VCHSRobots/RefWBot/sharedlib/README.md

### Shared Lib for both PC and RPi Based Programs

Some custom packages and modules need to be used by both the 
pc and the Raspberry Pi programs. These are stored here.
