VCHSRobots/RefWBot/pc/archive/README.md

### PC Water Bot Discarded Code Folder (Archive)

This folder contains python and related files that are no longer needed, or are somehow obsolete.
  They are kept here in case we need to refer to them to see how something was done.
