VCHSRobots/RefWBot/control_sys_white_board.jpg

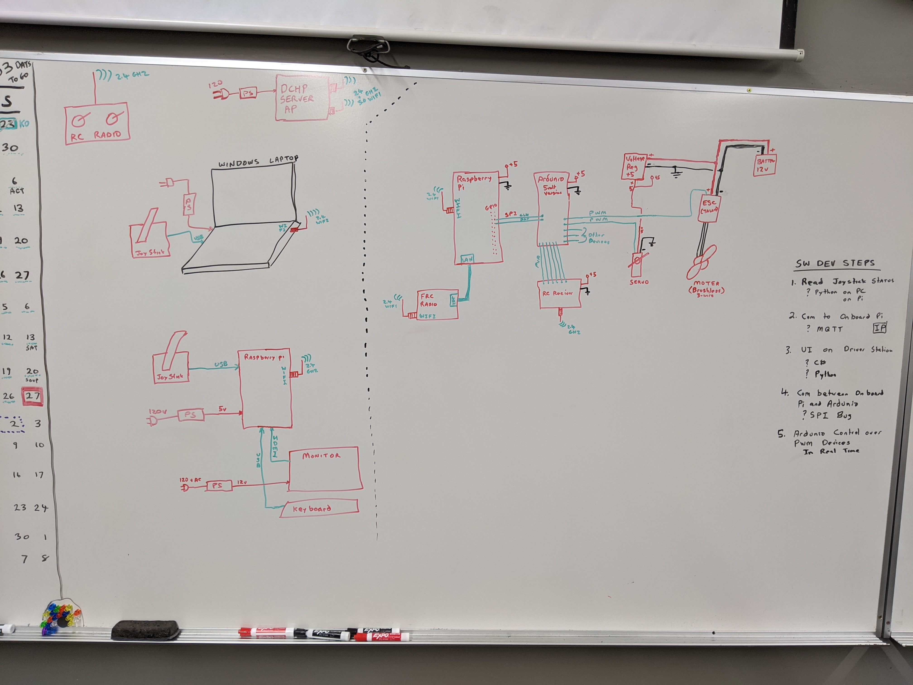
control_sys_white_board.jpg
