VCHSRobots/RefWBot/rpi/RPiHardware.PNG

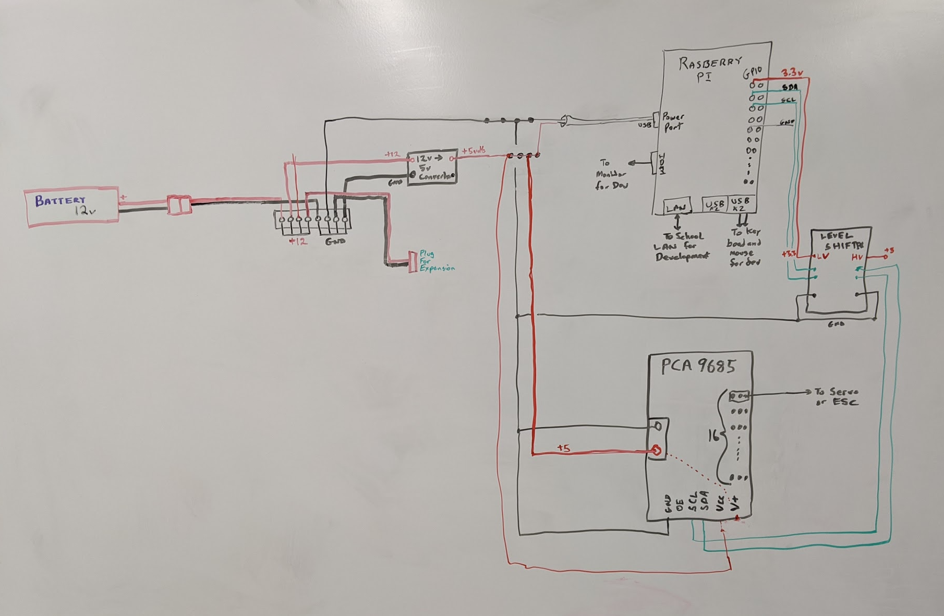
rpi/RPiHardware.PNG
