VCHSRobots/RefWBot/(commit log)

2021-02-11 first joy to servo demo
2021-02-12 Adding Motor to testing
2021-02-12 fixing for motor
2021-02-12 Schematic for bot
2021-02-12 adding schematic
2021-02-24 Fix to docs, new gps testing
    [test_gps.py]
2021-02-27 Motors Running on Demo Board. I2C problems inproved.
    [RobotRun.ino, i2ctst.py]
2021-02-27 Reorg and Demo Board Fixes
    [RobotRun.ino, botmain.py, run_pwm_motors.py, run_servo_motors.py, test_gps.py, test_joystick.py]
2021-02-27 All motors working on demo board
2021-03-09 Overhaul of Arduino package
2021-03-09 Overhaul of arduino package/class
2021-03-09 Arduino status in driver station, more refractoring
2021-03-10 bug fix in runbot
    [runbot.py]
2021-03-11 Improved error detection and recovery
    [drivestation.py, runbot.py, utils.py]
2021-03-12 fix bug to allow running with no electronics connected
    [runbot.py]
2021-03-18 Update for 2 batterys, bug fixes
    [RobotRun.ino, drivestation.py, runbot.py]
2021-03-20 New config Feature, more hw objects
    [dsconfig.txt, dsconfig_example.txt]
2021-03-20 Fixing Configuration Bugs
    [dsconfig.txt]
2021-03-20 tiny bug in arduino code
    [RobotRun.ino]
2021-03-20 Added set_hats to joystickwidget to prevent breakage
    [dsconfig_example.txt]
2021-03-20 Added support for multiple joysticks on the ui
    [dsconfig_example.txt]
2021-03-21 Arduino Reset Feature
2021-03-22 Upgrading Joysticks and Widgets
    [dsconfig_example.txt]
2021-03-23 Major UpGrade: 2 joysticks, better ui, XBox GamePad, Reset Feature
    [RobotRun.ino, drivestation.py, runbot.py]
2021-03-23 power outage 1
2021-03-23 power outage save 2
2021-03-23 fixing bug for running from anywhere
    [runbot.py]
2021-03-26 fixing buttons
